jim11662418/ESP8266-WiFi-Analog-Clock/images/Analog Clock.jpeg

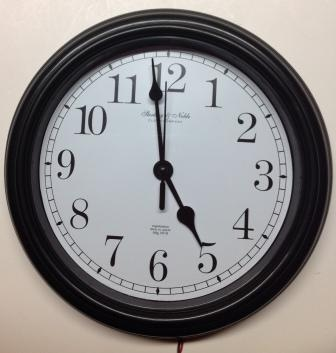
images/Analog Clock.jpeg
