jim11662418/ESP8266-WiFi-Analog-Clock/images/AnalogClockStatus.jpg

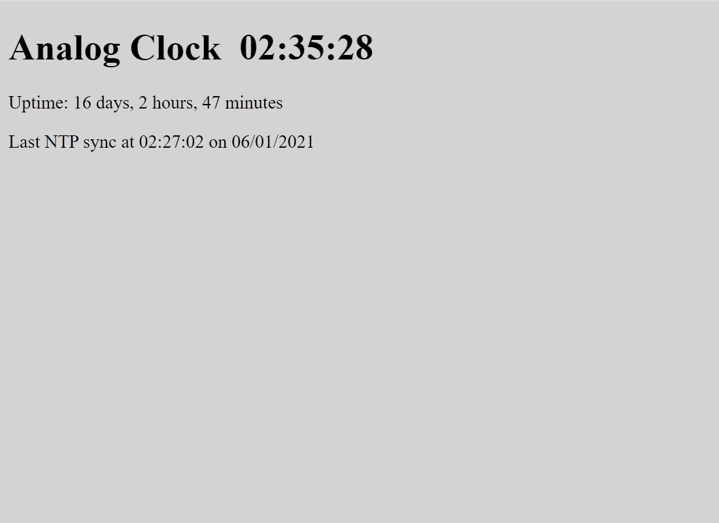
images/AnalogClockStatus.jpg
