jim11662418/ESP8266-WiFi-Analog-Clock/Schematic.pdf

A | B | C | D
1 | 1

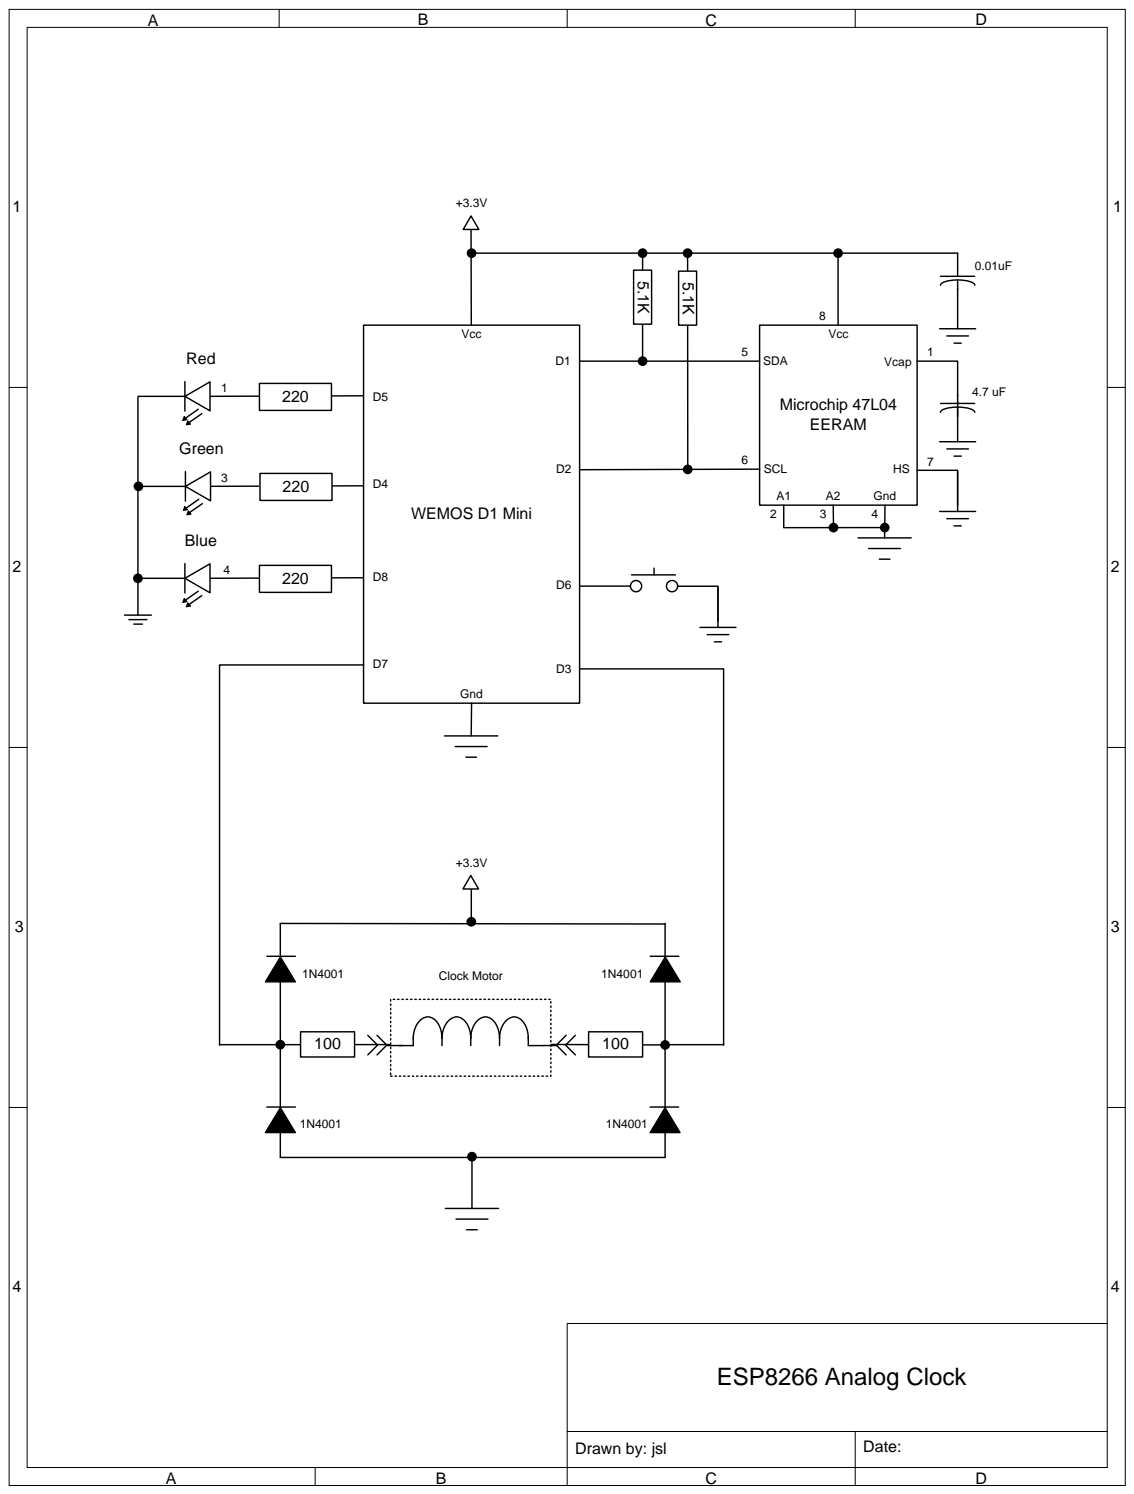
[picture p12: page 1]
