jim11662418/ESP8266-WiFi-Analog-Clock/images/AnalogClockSetup.jpg

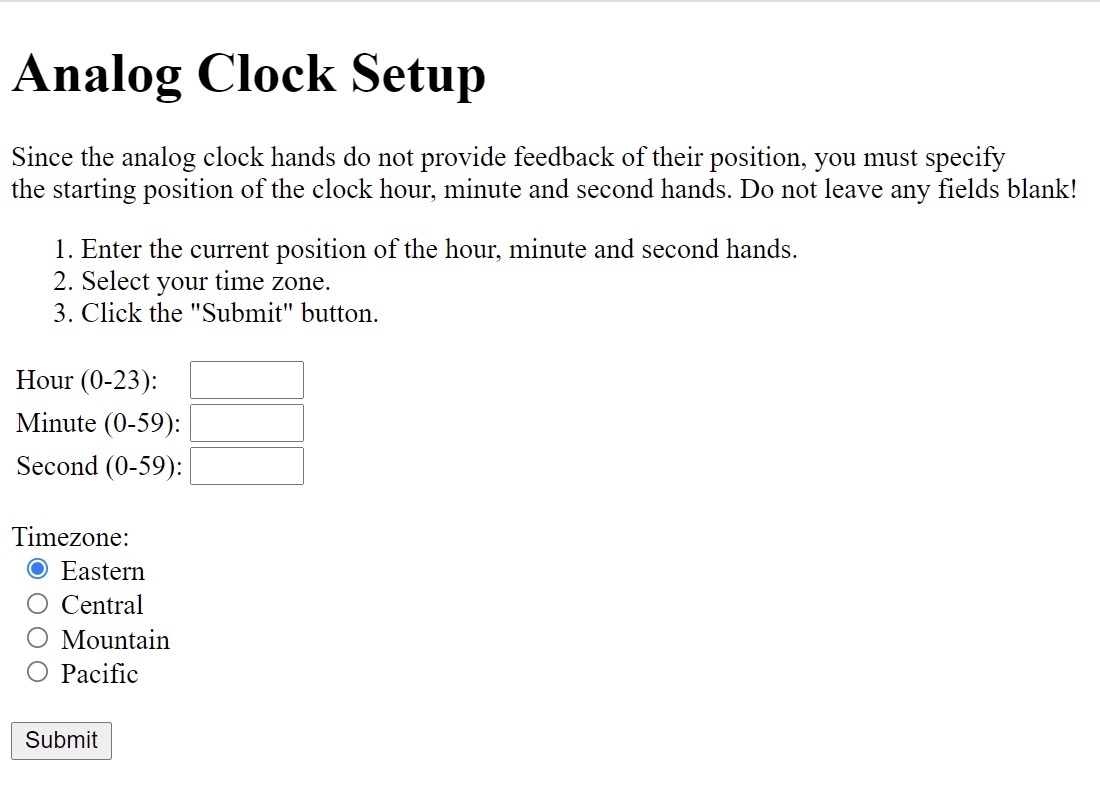
images/AnalogClockSetup.jpg
